hosung-cho/Bit_Up/C_SERV_ALU_FPGA/docs/260603_1455_백엔드.md

qflow synthesize -T etri050 serv_exec_unit
qflow place -T etri050 serv_exec_unit
qflow route -T etri050 serv_exec_unit
qflow migrate -T etri050 serv_exec_unit

cd layout
~/ETRI050_DesignKit/scripts/check_via_stack.py serv_exec_unit m2contact m3contact 6 | tee serv_exec_unit_Stacked.log

~/ETRI050_DesignKit/scripts/run_drc.sh serv_exec_unit | tee serv_exec_unit_DRC.log

~/ETRI050_DesignKit/scripts/run_lvs.sh serv_exec_unit | tee serv_exec_unit_LVS.log

[합성 후 시뮬레이션]
iverilog -g2005-sv -Tmin -gspecify \
  -o /tmp/serv_exec_unit_gate_tb \
  MPW_workspace/Bit_Up/C_SERV_ALU_FPGA/testbench/0_exec_unit_basic/tb_serv_exec_unit.v \
  ETRI-0.5um-CMOS-MPW-Std-Cell-DK/digital_ETRI/khu_etri05_stdcells.v \
  MPW_workspace/Bit_Up/C_SERV_ALU_FPGA/ETRI050_Ho/synthesis/serv_exec_unit_mapped.v

vvp /tmp/serv_exec_unit_gate_tb

make
make copy_pad_frame
make copy_core

[f-4. 코어와 입출력 패드 분리]
make extract_pad
make extract_pin_route
~/ETRI050_DesignKit/scripts/size_core.sh serv_exec_unit_Pin_Route

[배선 DRC]
magic -dnull -noconsole << EOF
drc off
box 0 0 0 0
load serv_exec_unit_Pin_Route.mag -force
select top cell
drc on
drc check
drc why
box
exit
EOF

[magic VLSI]
select cell instancename

make generate_gds

klayout -l ETRI050_CMOS.lyp serv_exec_unit_Top.gds
