hosung-cho/Bit_Up/A_MCU/docs/260520_0453_bridge_diet_area_recovery.md

# 260520_0453_bridge_diet_area_recovery

본 문서는 주변 시리얼 브리지 회로(`offchip_mem_bridge`, `serv_rf_ram_if`)의 제어 로직 및 FSM 다이어트를 수행한 1차 리팩토링 결과와 물리적 면적 재측정 보고서입니다.

---

## 1. 리팩토링 수행 내역

### A. `offchip_mem_bridge.v` 극단적 단순화
* **기존 방식**: `bit_count` 값에 따라 WE, IBUS, SEL 비트를 MUX하여 송신하느라 복잡한 비교기와 다단계 MUX 트리 조합 회로가 면적을 크게 소모함.
* **개선 방식**: `shift_reg` 크기를 32비트에서 **38비트**로 확장하여 헤더 데이터(active_we, active_ibus, active_sel)를 로드 시점에 사전 주입(Preload). `o_mem_mosi`는 오직 `shift_reg[37]` 최상위 비트 1개만을 바로 출력하도록 하여 **비교기 및 MUX 조합 회로를 완전히 제거**.

### B. `serv_rf_ram_if.v` 카운터 축소
* **기존 방식**: 시스템 클럭 기준으로 쓰기 대기 루프를 64사이클 대기하기 위해 `write_wait` 카운터를 6비트(`6'd63`)로 구현함.
* **개선 방식**: 시스템 클럭 1사이클이 패스트 클럭 32사이클에 해당하므로, 대기 카운터를 시스템 클럭 기준 **2사이클**(`2'd2`)로 대폭 축소. 카운터 크기를 **2비트**로 줄여 4개의 FF와 디코딩 로직을 제거함.

---

## 2. 시뮬레이션 및 백엔드 물리 결과

### A. 기능적 정합성 검증 (Vivado Simulation)
* 리팩토링 완료 후 `testbench/5_testbench_rv32i_directed/sim/run.sh` 를 통해 320개 RISC-V 32I Directed Testbench를 즉시 회귀 검증함.
* **검증 결과**: **100% PASS** (기능 및 오프칩 인터페이스 호환성 무결 입증)

### B. 백엔드 물리적 구현 및 면적 측정 결과
* Qflow 백엔드 합성, 배치 및 라우팅을 다시 수행하여 배치 밀도(`initial_density`)를 **`0.98`** 로 대폭 높여 설계를 조였습니다.

| 지표 | 리팩토링 전 (Density 0.90) | 리팩토링 + 고밀도 튜닝 (Density 0.98) | 개선율 |
| :--- | :---: | :---: | :---: |
| **Yosys Netlist Cells** | 2,291 개 | **2,260 개** | **31개 셀 제거** |
| **GrayWolf Placement Cells** | 2,483 개 | **2,451 개** | **32개 셀 제거** |
| **Routing Failure Nets** | 0 개 | **0 개 (100% Routing 완수)** | **정상 통과** |
| **최종 코어 가로 x 세로 크기** | 1350.6 um x 1341.75 um | **1305.9 um x 1269.75 um** | **가로 45um, 세로 72um 축소** |
| **최종 코어 면적 (Core Size)** | 1.81 mm² | **1.66 mm²** | **8.3% 추가 축소** |

---

## 3. 한계점 분석 및 최종 제언

브리지 로직 단순화와 `0.98` 극단적 배치 밀도 설정을 통해 **최종 면적을 `1.66 mm²` 까지 축소**하고 라우팅 에러 0개를 달성하는 훌륭한 성과를 거두었습니다. 

그러나 1mm x 1mm (1.00 mm²) 한계에 완전히 안착하기 위해서는 다음과 같은 본질적 구조 변경이 필요합니다:
* **포트/FSM 물리적 합병(Shared Serial Bus)**: 현재 메모리 액세스용 브리지와 RF RAM 액세스용 브리지가 각각 독립된 Shift Register와 카운터를 사용하여 약 850개 이상의 셀을 차지하고 있습니다. 이 두 채널을 단일 시리얼 버스 포트로 통합하고 시프트 버퍼를 공유하도록 아키텍처를 개조하면 추가로 약 300~400개 이상의 셀을 절감할 수 있으며, 이 경우에 한해 1mm x 1mm 이내 진입이 최종적으로 가능할 것으로 예상됩니다.
