hosung-cho/Bit_Up/A_MCU/docs/260520_0508_rf_module_merge_area.md

# 260520_0508_rf_module_merge_area

본 문서는 외부 RF RAM 제어 모듈(`serv_rf_ram.v`)과 어댑터 모듈(`serv_rf_ram_if.v`)을 물리적으로 완전히 병합(Merge)한 2차 리팩토링 결과와 물리적 면적 재측정 보고서입니다.

---

## 1. 리팩토링 수행 내역

### A. `serv_rf_ram.v` 모듈 완전 삭제 및 통합
* **기존 구조**:
  - `serv_rf_ram_if`와 `serv_rf_ram`이 이중 계층 구조를 이루어 다수의 제어선, 주소 버스(32비트), 데이터 버스들이 모듈의 물리 경계를 수시로 넘나들며 MUX 및 플러그 게이트 조합 회로들이 복잡하게 얽혀 있었습니다.
* **개선 구조**:
  - `serv_rf_ram.v` 내의 14비트 패스트 클럭(`i_clk_fast`) 기반 시리얼 전송 FSM을 `serv_rf_ram_if.v` 내부로 직접 흡수 및 이식하였습니다.
  - 이를 통해 `serv_rf_ram.v` 모듈을 **100% 영구 삭제**하였으며 계층 경계 라우팅과 포트 MUX 회로를 완벽하게 제거했습니다.

### B. MUX 디코더 중복 제거
* 읽어온 레지스터의 `x0` (0번 레지스터) 제로 마스킹 로직이 `serv_rf_ram` 내부와 `serv_rf_ram_if` 버퍼링 대입 시점에 이중으로 걸려 있던 것을, 내부 `rdata_w` 1회 필터링으로 일원화하여 불필요한 MUX들을 추가 감축하였습니다.

---

## 2. 시뮬레이션 및 백엔드 물리 결과

### A. 기능적 정합성 검증 (Vivado Simulation)
* 리팩토링 후 `testbench/5_testbench_rv32i_directed/sim/run.sh` 의 320개 RISC-V 32I Directed Testbench 회귀 검증을 즉시 수행하였습니다.
* **검증 결과**: **100% PASS** (모듈 합병 후에도 오프칩 RF RAM 기능이 정상적으로 호환 및 동작함을 입증)

### B. 백엔드 물리적 구현 및 면적 측정 결과
* Qflow 백엔드 합성, 배치 및 라우팅을 다시 수행하여 배치 밀도(`initial_density`)를 **`0.98`** 로 대폭 높여 설계를 조였습니다.

| 지표 | 1차 브리지 단순화 (Density 0.98) | 2차 모듈 병합 (Density 0.98) | 개선율 |
| :--- | :---: | :---: | :---: |
| **Yosys Netlist Cells** | 2,260 개 | **2,241 개** | **19개 셀 추가 제거** |
| **GrayWolf Placement Cells** | 2,451 개 | **2,427 개** | **24개 셀 추가 제거** |
| **Routing Failure Nets** | 0 개 | **0 개 (100% Routing 완수)** | **정상 통과** |
| **최종 코어 가로 x 세로 크기** | 1305.9 um x 1269.75 um | **1296.60 um x 1269.75 um** | **가로 9.3 um 추가 축소** |
| **최종 코어 면적 (Core Size)** | 1.66 mm² | **1.646 mm²** | **1.65 mm² 이하로 진입** |

---

## 3. 최종 제언 및 결론

모듈 병합 작업을 통해 **코어 면적을 `1.646 mm²`까지 추가 축소**하는 성과를 거두었습니다. 계층 제거와 MUX 소거로 물리적 합성과 배치기가 셀들을 더욱 강하게 모을 수 있는 구조적 바탕을 확립하였으며, 라우팅 또한 에러 없이 안정적으로 100% 완수되었습니다.
이러한 모듈 병합 및 FSM 결합 기법은 향후 칩에 다른 인터페이스(예: SPI 메모리 버스)를 공유 버스로 묶어 대단위 아키텍처 단순화를 이뤄내는 데 중요한 기틀이 될 것입니다.
