hosung-cho/Bit_Up/A_MCU/docs/260519_2040_MUX_최적화_후_물리_합성_면적_재검증.md

# 260519 20:40 MUX 최적화 후 물리 합성 면적 재검증

## 1. 목적
- GPR RAM 인터페이스 및 오프칩 메모리 브릿지의 Dynamic MUX 제거 최적화(Shift Register 구조 도입)가 실제 ETRI 0.5um 공정 QFlow 물리 합성 결과(DIE Area 및 Standard Cell Count)에 미친 영향을 정량적으로 비교 분석한다.

---

## 2. QFlow 물리 합성 결과 비교 분석 (USE_EXT_SYS_CLK = 1 기준)

MUX 최적화 이전(기존 외부 slow clock 모드)과 최적화 이후의 Yosys 합성 결과 및 DEF 배치 결과를 비교한 수치입니다.

| 항목 | 최적화 이전 (기존 외부 클록 모드) | 최적화 이후 (현재 결과) | 증감 수치 / 비율 |
| :--- | :---: | :---: | :---: |
| **전체 Logic Cells** | 2,660 개 | **2,894 개** | +234 개 (+8.8%) |
| **DFFPOSX1 (D Flip-Flop)** | 339 개 | **371 개** | +32 개 (+9.4%) |
| **OAI21X1 (Logic Gate)** | 563 개 | **701 개** | +138 개 (+24.5%) |
| **vlogFanout 추가 Buffers** | 241 개 | **296 개** | +55 개 (+22.8%) |
| **DEF Placement Components** | 4,822 개 | **5,273 개** | +451 개 (+9.4%) |
| **DEF DIE Area (폭 x 높이)** | 1449.0um x 1419.0um | **1491.0um x 1491.0um** | - |
| **DEF 최종 면적** | 2.056 mm² | **2.223 mm²** | **+0.167 mm² (+8.1%)** |

---

## 3. 면적 증가 원인 분석

### A. D Flip-Flop (DFFPOSX1)의 물리적 면적 부하
- `offchip_mem_bridge.v`에서 기존에 MUX 트리(70비트 wire)로 직접 나가던 구조를 32비트 송신용 쉬프트 레지스터(`shift_tx`)로 구조화하면서 **32비트의 DFF가 설계에 추가**되었습니다.
- ETRI 0.5um 공정에서 `DFFPOSX1`은 1개당 `36um x 36um`로, 일반 게이트(예: `INVX1` `6um x 36um`, `NAND2X1` `12um x 36um`) 대비 물리적 폭이 3배에서 6배에 달할 정도로 면적 소모가 매우 큽니다. 따라서 32개의 DFF가 추가된 것만으로도 막대한 물리 면적 부하를 유발했습니다.

### B. Shift & Hold 멀티플렉싱에 따른 추가 로직 게이트 발생
- MUX 구조는 Yosys 합성기에서 조합 회로(combinational cell)로 공유 및 간소화되기 쉬운 형태입니다.
- 반면, 쉬프트 레지스터는 각 플롭의 입력(D)단에 **[1] 기존 데이터 홀드**, **[2] 1비트 우측 쉬프트**, **[3] 2비트 우측 쉬프트**, 또는 **데이터 로드**의 다중 조건 분기를 처리하기 위한 개별 멀티플렉서 기능(MUX2X1 및 OAI21X1/AOI21X1 복합 게이트)이 모든 비트마다 독립적으로 부착되어야 합니다.
- 이로 인해 `OAI21X1`이 **563개에서 701개**로 138개나 폭증하였으며, 이것이 전체 로직 셀 증가의 주요 원인이 되었습니다.

### C. Fanout 버퍼 추가 증가
- 레지스터(DFF)의 개수 증가 및 쉬프트 레지스터의 인에이블/제어 신호 로드가 분산되면서 `vlogFanout` 단계에서 추가적으로 삽입된 버퍼의 개수가 241개에서 **296개**로 늘어났습니다.

---

## 4. 결론 및 향후 개선 방향
- **분석 결론**: Dynamic MUX 트리를 Shift Register 구조로 변경하면 논리 레벨(Logical Area Metric) 상의 대형 MUX는 제거되어 정돈되는 효과가 있으나, 실제 ETRI 0.5um 공정의 물리적 Standard Cell 배치 레벨에서는 **추가된 32비트 DFF의 면적 부하** 및 **비트별 쉬프트 선택 로직 오버헤드**가 더 지배적이어서 **실제 DIE Area는 8.1% 증가**하는 결과를 낳았습니다.
- **향후 방향**:
  1. GPR RAM 인터페이스 및 브릿지 구조에서 Shift Register를 사용한 완전 순차 직렬화 대신, **합성 단계에서 논리 연산 공유가 가능한 최소 단위의 MUX 분할 구조**를 재설계하는 것이 실질적인 셀 폭 감소에 유리할 수 있습니다.
  2. 목표 면적인 `1.0 mm²` 진입을 위해서는 단순한 MUX 구조 수정뿐만 아니라, **UART/GPIO 등 부가 IO 모듈의 제거**, **프레임 비트 폭 자체의 대폭 축소(예: 32비트에서 16/8비트 직렬화)** 등 구조적 크기를 과감히 도려내는 탑 레벨 분리 시도가 필수적입니다.
