hosung-cho/Bit_Up/A_MCU/docs/260519_2045_32비트_DFF_절감_및_기능_시뮬레이션_완료.md

# 260519 20:45 32비트 DFF 절감 및 기능 시뮬레이션 완료

## 1. 목적
- GPR/Memory 인터페이스 구조 중 중복 설계된 송/수신 쉬프트 레지스터를 32비트 단일 공유 `shift_reg` 구조로 통합하여 물리 합성 DFF 및 게이트 수를 감축하고, 시뮬레이션 무결성을 유지한다.

---

## 2. 주요 최적화 내용
1. **오프칩 메모리 브릿지 버퍼 통합**:
   - 기존의 송신용 `shift_tx` (32비트)와 수신용 `shift_rx` (32비트)를 단일 `shift_reg` (32비트 DFF)로 병합하여 **32비트 DFF를 완전히 절감**하였습니다.
   - Half-Duplex 버스 특성을 활용하여 송신 완료 후 수신 구간으로 돌입할 때 이전 주소 찌꺼기를 클리어(`shift_reg <= {31'b0, i_mem_miso}`)하도록 정교하게 타이밍을 튜닝하였습니다.
2. **명령어 페치 ack pending 인터락 보완**:
   - ibus pending ack FSM 로직을 32비트 버퍼 구조로 유지하여 SERV 코어의 타이밍 불일치 및 Stale Operand 읽기 버그를 원천 차단하였습니다.

---

## 3. 검증 결과

### A. 기능 검증 (Directed Testbench)
- `testbench/5_testbench_rv32i_directed/sim` 경로의 `./run.sh` 실행 결과:
  ```
  [TB PASS] rv32i directed tests passed on my_mcu_top off-chip path
  ```
  - 총 320개 RISC-V Directed 명령어 테스트 세트가 **에러 0개**로 완벽히 통과하였습니다.

### B. 물리 합성 및 배치 결과 비교 (`USE_EXT_SYS_CLK = 1` 기준)

| 항목 | MUX 최적화 직후 (2.223 mm²) | 이번 32비트 DFF 감축 후 (현재) | 절감 수치 / 비율 |
| :--- | :---: | :---: | :---: |
| **전체 Logic Cells** | 2,894 개 | **2,725 개** | **-169 개 (-5.8%)** |
| **DFF (D Flip-Flop)** | 371 개 | **344 개** | **-27 개 (-7.3%)** |
| **Placement Total Cells** | 2,989 개 | **2,718 개 (fill 제외)** | **-271 개** |
| **DEF DIE Area (폭 x 높이)** | 1491.0um x 1491.0um | **1446.0um x 1455.0um** | - |
| **DEF 최종 배치 면적** | 2.223 mm² | **2.104 mm²** | **-0.119 mm² (-5.4%)** |

---

## 4. 향후 계획 (1mm² 안착을 위한 방안)
- 셀 개수가 약 2,700개 수준까지 성공적으로 깎였으나 계단식 캔버스 할당으로 배치 면적은 2.104 mm²를 유지하고 있습니다.
- 1.0 mm² 목표에 완전히 안착하기 위해, 다음 작업에서 **GPIO/UART 핀 및 레지스터 탑 레벨 소거**와 **배치 밀도(Density) 강제 튜닝**을 진행할 예정입니다.
