hosung-cho/Bit_Up/A_MCU/docs/260519_1945_물리구현_결과_기반_면적_최적화_방안.md

# 260519 19:45 물리 구현 결과 기반 면적 최적화 방안

## 1. 물리 배치 및 레이아웃 로그 분석 (ETRI 0.5um 공정 타겟)

물리 배치 툴(GrayWolf) 및 라우팅 툴(qrouter)의 로그(`place.log`)와 설정 파일(`project_vars.sh`)을 정밀 분석한 결과는 다음과 같습니다.

### ① 배치 밀도 (Standard Cell Density / Utilization)
* **설정값**: `initial_density = 0.90` (90%)
* **실제 매핑 결과**:
  * 스탠다드 셀(Other cells): 2,894개
  * 채움 셀(Fill cells): 1,855개
  * 실 스탠다드 셀 점유 폭 비율: **88.89%** (약 89% 수준의 극도로 높은 집적도 유지)
* **해석**: 3층 금속 배선 레이어(M1, M2, M3)만 사용하는 구형 ETRI 0.5um 공정에서 89%의 배치 밀도는 물리적으로 **거의 한계치**에 다다른 수준입니다. 90% 이상으로 밀도를 강제 조절할 경우 배치 툴의 겹침 현상(overlap)이나 라우팅 채널 부족으로 인해 최종 라우팅 실패(Congestion)가 발생할 확률이 매우 높습니다. 
* **결론**: 물리적인 배치 밀도 파라미터 튜닝만으로는 추가적인 면적 감소가 불가능하며, **스탠다드 셀(특히 플립플롭)의 물리적 크기와 개수 자체를 줄여야 합니다.**

### ② 배선 레이어 제한에 따른 전력 구조(Power Strip) 손실
* **배선 레이어 수**: 3 Layers (M1, M2, M3)
* **로그 내용**: `Will not generate over-cell power stripes due to lack of route layers. Generating comb structures instead.`
* **해석**: 라우팅용 금속판이 3개층뿐이라 셀 위를 교차하는 통상적인 메쉬(Mesh)형 전력 배선(Power Stripe)을 생성하지 못하고, 칩 외곽을 둘러싸는 빗 모양(Comb) 전력 배선 구조를 사용하고 있습니다. 
* **결론**: Comb 구조는 외곽 전력 라인의 두께와 가드로 인해 Die Area 마진을 더 많이 요구하게 됩니다. 라우팅을 방해하지 않는 선에서 Comb 전력 라인의 폭을 최적화할 필요가 있습니다.

---

## 2. ETRI 0.5um 공정 라이브러리 특성 분석

물리 합성(`synth.log`)에 정의된 ETRI 0.5um CMOS 표준 셀 라이브러리(`khu_etri05_stdcells.lib`)의 셀별 물리 면적(Chip Area) 값은 다음과 같습니다.

| 표준 셀 이름 | 기능 및 특징 | 물리 면적 (Area 수치) | 인버터(`INVX1`) 대비 크기 비율 |
| :--- | :--- | :---: | :---: |
| **`INVX1`** | 기본 인버터 | 144 | 1.0배 |
| **`NAND2X1`** | 2입력 NAND 게이트 | 216 | 1.5배 |
| **`AND2X1`** | 2입력 AND 게이트 | 288 | 2.0배 |
| **`DFFPOSX1`** | 일반 D-플립플롭 | **864** | **6.0배** |
| **`DFFSR`** | **비동기 Reset/Set 지원 D-플립플롭** | **1,584** | **11.0배** |

### ⚠️ 핵심 발견: DFFSR 셀의 비정상적으로 큰 물리 면적
* 비동기 리셋 및 셋 단자를 모두 지원하는 `DFFSR` 플롭은 단일 셀 면적이 **1,584**로, 일반 플립플롭(`DFFPOSX1`)의 **1.8배**, 기본 NAND 게이트의 **7.3배**, 인버터의 **11배**에 달하는 초대형 셀입니다.
* 현재 `my_mcu_top.v`에는 인터록 명령어 대기 버퍼(`ibus_pending_rdt[31:0]`)를 포함하여 총 46개의 비동기 리셋 레지스터가 존재하며, 이들은 전부 이 거대한 `DFFSR` 셀로 합성되었습니다.
* 이 46개의 `DFFSR`이 차지하는 물리 면적 합계만 **72,864**에 달해 `my_mcu_top` 로컬 면적의 절반 이상을 차지합니다.

---

## 3. 물리 구현 관점에서의 면적 최소화 방안

공정 라이브러리의 물리적 특성과 레이아웃 제약을 극복하기 위해 제안하는 구체적인 물리적 면적 최적화 기법입니다.

### 💡 제안 1: 비동기 리셋(`DFFSR`)을 동기 리셋(`DFFPOSX1`+조합회로)으로 전환
* **원리**: 
  * 현재의 `always @(posedge clk_sys or posedge rst)` 구조의 비동기 리셋을 `always @(posedge clk_sys)` 기반의 **동기 리셋(Synchronous Reset)** 구조로 모두 전환합니다.
  * 동기 리셋으로 설계할 경우 Yosys는 비동기식 대형 `DFFSR` 셀 대신, 훨씬 크기가 작은 일반 `DFFPOSX1` (864) 셀의 데이터 입력 D단 앞에 리셋 조합 회로(AND 등)를 결합하여 합성하게 됩니다.
* **물리 면적 절감 효과**:
  * 비동기 `DFFSR` 1개 면적: **1,584**
  * 동기식 구현 면적: `DFFPOSX1` (864) + `AND2X1` (288) = **1,152** (셀 1개당 무조건 432의 면적이 즉시 절감됨)
  * 또한, 리셋이 0으로 풀리는 단순 레지스터의 경우 Yosys가 전단 조합 논리와 리셋 AND 회로를 병합(Logic Optimization)해 주므로, 실제 288 면적의 AND 게이트조차 상당 부분 축소되거나 완전히 병합되어 면적이 1,152 이하로 내려갑니다.
  * MCU 전체의 비동기 리셋 플롭을 동기 리셋으로 전환 시, **수 만 단위의 물리 면적이 소스 코드 수정 없이 합성기 최적화만으로도 절감**됩니다.

### 💡 제안 2: Wishbone 버스 게이팅을 활용한 플립플롭 원천 제거 (DFF 카운트 최소화)
* **원리**: 앞선 논리 분석에서 도출된 Wishbone `cyc` 게이팅 기반 인터록 지연 방식을 적용하면 32비트 명령어 대기 버퍼 자체를 아예 지울 수 있습니다.
* **물리 면적 절감 효과**:
  * 이 변경은 단순히 게이트 수를 줄이는 것을 넘어, ETRI 0.5um 공정에서 가장 비싼 `DFFSR` 셀을 32개 이상 통째로 들어내는 효과를 갖습니다.
  * `32개 * 1,584 (DFFSR 면적) = 50,688` 면적이 물리 레이아웃에서 즉각 삭제됩니다.

### 💡 제안 3: Comb 전력 스트라이프 폭 마진 조정
* **원리**: Qflow 배치 스크립트(`addspacers`)의 전력선 폭 제약 파라미터를 조정하여 외곽 Comb 구조의 Guard Ring 폭 및 내부 전력 밀도를 다듬습니다.
* **물리 면적 절감 효과**:
  * 3 Layer 메탈 한계상 외곽 Comb 라인이 강제되므로, 이 외곽 전력 라인의 폭을 수 마이크론 단이로 최적화해 주는 것만으로도 칩의 전체 테두리(Die Area)를 크게 줄일 수 있는 물리적 여유가 생깁니다.

---

## 4. 요약 및 권고사항

ETRI 0.5um 구형 공정에서는 **플립플롭(특히 비동기 리셋 플롭)이 면적 낭비의 근본 원인**으로 확인되었습니다. 물리 구현의 한계를 극복하고 1mm² 영역에 근접하기 위한 권고사항은 다음과 같습니다.

1. **동기 리셋 적극 도입**: `my_mcu_top` 및 우리가 수정한 시리얼 브릿지 내의 모든 `always @(posedge clk or posedge rst)` 구문을 `always @(posedge clk)` 형태의 동기식 리셋으로 통일해 초대형 `DFFSR` 셀 유입을 차단합니다.
2. **Shift Register 구조 도입을 통한 MUX 축소**: 물리 레이아웃 배선층이 3개뿐이므로, 70:1 MUX나 32:1 MUX는 수많은 배선 혼잡도를 유발하고 필 셀(Fill cell)을 강제 배치하게 만듭니다. MUX를 Shift Register로 분해하면 배선 레이아웃 복잡도도 함께 줄어들게 됩니다.
3. **인터록 단순화**: `DFFSR` 개수를 절대적으로 줄이기 위해 32비트 명령어 지연 버퍼를 Wishbone 게이팅 방식으로 리팩토링합니다.
