hosung-cho/Bit_Up/A_MCU/backend_physical_qflow/synthesis/my_mcu_top_synth.rtl.v

/* Verilog module written by vlog2Verilog (qflow) */
/* With explicit power connections */

module my_mcu_top(
    inout vdd,
    inout gnd,
    input i_clk_fast,
    input i_clk_sys_ext,
    input i_rst_n,
    output o_mem_sync,
    output o_mem_sck,
    output o_mem_mosi,
    input i_mem_miso
);

wire o_mem_sck ;
wire current_stream_rs2_hint ;
wire _588_ ;
wire _168_ ;
wire _800_ ;
wire _60_ ;
wire _1066_ ;
wire _397_ ;
wire [0:0] \u_cpu.ctrl.pc_plus_4_cy_r_w  ;
wire _703_ ;
wire [4:0] \u_cpu.decode.opcode  ;
wire _19_ ;
wire _932_ ;
wire _512_ ;
wire _1198_ ;
wire _741_ ;
wire _321_ ;
wire _57_ ;
wire _970_ ;
wire _550_ ;
wire _130_ ;
wire [4:2] \u_cpu.state.o_cnt  ;
wire _606_ ;
wire _835_ ;
wire _415_ ;
wire _95_ ;
wire _644_ ;
wire _224_ ;
wire _1122_ ;
wire _873_ ;
wire _453_ ;
wire _929_ ;
wire _509_ ;
wire _682_ ;
wire _262_ ;
wire _738_ ;
wire _318_ ;
wire _1160_ ;
wire _491_ ;
wire _1216_ ;
wire _967_ ;
wire _547_ ;
wire _127_ ;
wire _1025_ ;
wire _776_ ;
wire _356_ ;
wire _585_ ;
wire _165_ ;
wire _1063_ ;
wire _394_ ;
wire _1119_ ;
wire _679_ ;
wire _259_ ;
wire _1157_ ;
wire _488_ ;
wire _700_ ;
wire _297_ ;
wire _16_ ;
wire _1195_ ;
wire _54_ ;
wire _603_ ;
wire _832_ ;
wire _412_ ;
wire _92_ ;
wire _1098_ ;
wire _641_ ;
wire _221_ ;
wire _870_ ;
wire _450_ ;
wire _926_ ;
wire _506_ ;
wire _735_ ;
wire _315_ ;
wire [3:0] rf_wreg0_to_if ;
wire _1213_ ;
wire _964_ ;
wire _544_ ;
wire _124_ ;
wire _1022_ ;
wire _773_ ;
wire _353_ ;
wire _829_ ;
wire _409_ ;
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
    .B(_102_),
    .Y(_742_)
);

NAND3X1 _2168_ (
    .vdd(vdd),
    .gnd(gnd),
    .A(\u_rf_if.rcnt [0]),
    .B(\u_rf_if.rcnt [2]),
    .C(\u_rf_if.rcnt [1]),
    .Y(_103_)
);

OAI21X1 _2169_ (
    .vdd(vdd),
    .gnd(gnd),
    .A(_1145_),
    .B(_21_),
    .C(_1225_),
    .Y(_104_)
);
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
