hosung-cho/Bit_Up/A_MCU/testbench/4_2_testbench_my_mcu_top_no_csr/tb_my_mcu_top_no_csr.v

`timescale 1ns/1ps

module tb_my_mcu_top_no_csr;
   localparam RF_RAW = 5;
   localparam RF_REGS = 32;
   localparam RF_FRAME_BITS = RF_RAW + 8;
   localparam RESULT_BASE = 32'h0000_0700;

   localparam OPC_LUI       = 7'b0110111;
   localparam OPC_JAL       = 7'b1101111;
   localparam OPC_JALR      = 7'b1100111;
   localparam OPC_BRANCH    = 7'b1100011;
   localparam OPC_LOAD      = 7'b0000011;
   localparam OPC_STORE     = 7'b0100011;
   localparam OPC_ARI_RTYPE = 7'b0110011;
   localparam OPC_ARI_ITYPE = 7'b0010011;

   localparam FNC_BEQ     = 3'b000;
   localparam FNC_BNE     = 3'b001;
   localparam FNC_LW      = 3'b010;
   localparam FNC_SB      = 3'b000;
   localparam FNC_SH      = 3'b001;
   localparam FNC_SW      = 3'b010;
   localparam FNC_ADD_SUB = 3'b000;
   localparam FNC_SLL     = 3'b001;
   localparam FNC_XOR     = 3'b100;
   localparam FNC7_0      = 7'b0000000;

   reg clk_fast = 1'b0;
   reg rst_n = 1'b0;
   always #31.25 clk_fast = ~clk_fast;

   wire rf_sync;
   wire rf_sck;
   wire rf_mosi;
   wire rf_miso;
   wire mem_sync;
   wire mem_sck;
   wire mem_mosi;
   wire mem_miso;
   wire [7:0] gpio_out;
   wire [7:0] gpio_oe;

   my_mcu_top dut (
      .i_clk_fast(clk_fast),
      .i_rst_n(rst_n),
      .o_rf_sync(rf_sync),
      .o_rf_sck(rf_sck),
      .o_rf_mosi(rf_mosi),
      .i_rf_miso(rf_miso),
      .o_mem_sync(mem_sync),
      .o_mem_sck(mem_sck),
      .o_mem_mosi(mem_mosi),
      .i_mem_miso(mem_miso),
      .o_uart_tx(),
      .i_uart_rx(1'b1),
      .i_gpio(8'ha5),
      .o_gpio(gpio_out),
      .o_gpio_oe(gpio_oe)
   );

   reg [31:0] pico_ram [0:RF_REGS-1];
   reg [RF_FRAME_BITS-1:0] rx_buffer = 0;
   integer bit_cnt = 0;
   reg [1:0] pico_tx_data = 0;
   integer frame_cnt = 0;
   integer write_frame_cnt = 0;
   integer read_frame_cnt = 0;
   integer invalid_rf_frame_cnt = 0;

   reg [31:0] ext_mem [0:511];
   reg [69:0] mem_rx_buffer = 0;
   integer mem_bit_cnt = 0;
   reg [31:0] mem_read_shift = 0;
   reg [31:0] mem_addr = 0;
   reg [31:0] mem_wdata = 0;
   reg [3:0] mem_sel = 0;
   integer mem_word_index = 0;
   integer mem_frame_cnt = 0;
   integer mem_write_cnt = 0;
   integer mem_read_cnt = 0;
   integer fetch_cnt = 0;
   reg [31:0] last_ibus_adr = 0;
   reg [31:0] last_ibus_insn = 0;

   reg expected_valid [0:511];
   reg [31:0] expected_mem [0:511];
   reg [5:0] expected_case_id [0:511];
   reg [8*64-1:0] case_name [0:63];

   integer i;
   integer pc_word;
   integer result_addr;
   integer error_cnt = 0;
   integer case_count = 0;

   function [31:0] enc_r;
      input [6:0] funct7;
      input [4:0] rs2;
      input [4:0] rs1;
      input [2:0] funct3;
      input [4:0] rd;
      begin
         enc_r = {funct7, rs2, rs1, funct3, rd, OPC_ARI_RTYPE};
      end
   endfunction

   function [31:0] enc_i;
      input [31:0] imm;
      input [4:0] rs1;
      input [2:0] funct3;
      input [4:0] rd;
      input [6:0] opcode;
      begin
         enc_i = {imm[11:0], rs1, funct3, rd, opcode};
      end
   endfunction
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
