hosung-cho/Bit_Up/(commit log)

2026-05-15 docs 파일 추가
2026-05-15 serv 원본 코드 추가
2026-05-15 External RF(Off-chip Register File)를 위한, serv_rf_ram.v 수정, tb_external_rf 추가
    [tb_external_rf.v]
2026-05-15 시뮬레이션 관련 파일 추가 및 .gitignore 업데이트
2026-05-15 serv 폴더 이동
2026-05-16 테스트벤치 폴더 정리
2026-05-16 SoC 최상위 모듈(my_mcu_top.v) 추가, 오프칩 RF 통합
2026-05-16 my_mcu_top 클럭 수정 - my_mcu_top 모듈의 클럭 입력을 i_clk_fast로 변경하고, 클럭 분주 로직을 수정하여 시스템 클럭을 개선함. 테스트벤치에서 클럭 입력을 업데이트하고, 시뮬레이션 대기 시간을 조정함.
    [my_mcu_top.v, tb_my_mcu_top.v]
2026-05-16 Wishbone 버스와 주변장치 연계 구조 문서 추가
2026-05-16 test 삭제
2026-05-16 my_mcu_top 모듈에 오프칩 메모리 브리지 추가 및 RF 인터페이스 개선 - my_mcu_top.v: 오프칩 메모리 브리지와 관련된 신호 추가 및 RF 레지스터 읽기 로직 수정 - serv_rf_ram_if.v: 쓰기 대기 카운터 비트 수 증가 및 관련 로직 수정 - serv_top.v: immdec 모듈에 SHARED_RFADDR_IMM_REGS 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
    [my_mcu_top.v, offchip_mem_bridge.v, tb_my_mcu_top.v]
2026-05-16 오프칩 메모리 통합 및 RF writeback ordering 수정
    - testbench에서 GPIO 핀을 추가하고, GPIO 관련 신호를 DUT에 연결함.
    - 메모리 맵을 확장하여 pico_ram의 크기를 16에서 32로 증가시킴.
    - off-chip 메모리 브리지와 RF 어댑터의 통합 테스트를 위한 새로운 테스트 프로그램 추가.
    - RF writeback ordering 문제를 해결하기 위해 serv_rf_ram_if 모듈에 forwarding table 추가.
    - simple_gpio 모듈을 추가하여 메모리 맵 GPIO 슬레이브 구현.
    - 기존 임시 보정 로직을 제거하고, RF 어댑터 내부에서 write-after-read ordering을 보장하도록 수정.
    - 통합 테스트에서 ALU writeback 결과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
    [my_mcu_top.v, simple_gpio.v, tb_my_mcu_top.v]
2026-05-16 폴더 구조 변경 - A_MCU, B_8bit 폴더 추가
2026-05-16 B_8bit 추가
2026-05-16 ALU writeback 오염 문제 해결을 위한 RF writeback ordering 수정
    [my_mcu_top.v, tb_rf_if_serial.v]
2026-05-16 브랜치 점프 및 CSR Smoke 테스트와 Off-chip/Pico Parser 동기화 작업 추가 - RF serial frame width를 14-bit로 확장하고, CSR shadow register를 포함하여 기존 13-bit에서 변경하였습니다. - CSR write/readback 경로를 수정하여 `mscratch`, `mtvec`, `mepc`,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
    [my_mcu_top.v, tb_my_mcu_top.v, tb_rf_if_serial.v, tb_serial_external_rf.v]
2026-05-16 RV32I ISA smoke 테스트 추가 및 RF writeback 문제 수정
    [my_mcu_top.v, tb_my_mcu_top.v]
2026-05-17 mepc RAW hazard 해결 및 RF read 주소 디코딩 기능 추가
2026-05-17 RV32I Off-chip MCU 진행상태 및 테스트 확장 계획 문서 추가
2026-05-17 테스트벤치 및 시뮬레이션 스크립트 추가
    - 메모리 및 레지스터 파일 경로를 정의하는 mem_path.vh 파일 추가
    - RISC-V 명령어와 기능 코드를 정의하는 opcode.vh 파일 추가
    - Vivado 시뮬레이션을 위한 run.bat 및 run_sim.tcl 파일 추가
    - 외부 프로그램을 위한 smoke 테스트를 포함하는 external_smoke.S 및 링크 스크립트 link.ld 추가
    - 테스트벤치에서 사용할 .gitignore 파일 추가
    - 외부 smoke 테스트를 빌드하는 build_external_smoke.sh 스크립트 추가
    - rv32i_directed 테스트벤치 tb_rv32i_directed.v 파일 추가
2026-05-17 테스트벤치에 외부 스모크 테스트 추가
    - 새로운 어셈블리 파일 `external_smoke.S` 추가: 기본적인 레지스터 쓰기 및 무한 루프 구현.
    - 링커 스크립트 `link.ld` 추가: 텍스트 섹션 정의.
    - `.gitignore` 파일 추가: 생성된 파일 및 작업 공간 디렉토리 무시.
    - 외부 스모크 테스트 빌드 스크립트 `build_external_smoke.sh` 추가: ELF 및 바이너리 파일 생성, 메모리 초기화 파일 생성.
    - 시뮬레이션 실행 스크립트 `run.sh` 추가: Vivado 배치 모드에서 시뮬레이션 실행.
    - 직접 시뮬레이션 실행 스크립트 `run_direct.sh` 추가: Verilog 소스 파일 컴파일 및 시뮬레이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
2026-05-17 외부 Hex 시뮬레이션 정상화 및 기본값 설정을 위한 환경 변수 추가
2026-05-17 외부 Hex 기반 RV32I Directed Regression 완전 구축 및 PASS 검증 문서 추가
2026-05-17 테스트벤치 rv32i 컴플라이언스 추가(RISC-V 공식 테스트): Vivado Tcl 스크립트 및 Verilog 테스트벤치 파일 생성
2026-05-17 Dhrystone 2.1 벤치마크를 위한 RISC-V 테스트벤치 추가
    - 링크 스크립트(link.ld) 추가
    - Dhrystone 실행 파일(dhrystone.bin) 및 ELF 파일(dhrystone.elf) 생성
    - 외부 헥스 파일 설정을 위한 Verilog 파일(external_hex_config.vh, external_hex_init.vh) 추가
    - 프로그램 헥스 파일(program.hex) 및 원시 헥스 파일(program.hex.raw) 생성
    - 외부 사용 플래그(use_external.flag) 추가
    - 시뮬레이션 실행 스크립트(run.sh) 추가
    - Vivado Tcl 시뮬레이션 스크립트(run_sim.tcl) 추가
    - Dhrystone 테스트벤치(tb_rv32i_dhrystone.v) 추가
2026-05-17 ETRI 0.5um 공정에 대한 Yosys 합성 스크립트 및 보고서 추가
2026-05-17 serv_rf_ram_if 모듈의 레지스터 구조 최적화 및 Dhrystone 벤치마크 관련 파일 업데이트
2026-05-17 serv_rf_ram_if 모듈의 레지스터 구조 최적화: bypass_ram 및 bypass_valid 크기 조정
2026-05-17 my_mcu_top 모듈의 클럭 및 리셋 구조 단순화, offchip_mem_bridge 모듈의 불필요한 레지스터 제거, serv_rf_ram_if 모듈의 데이터 처리 방식 개선
2026-05-17 my_mcu_top 모듈의 클럭 및 리셋 구조 개선, offchip_mem_bridge 모듈의 레지스터 출력 타입 변경, serv_rf_ram_if 모듈의 레지스터 구조 최적화, tb_rv32i_directed 테스트벤치의 파라미터 조정
2026-05-17 my_mcu_top 모듈의 CSR 처리 조건 수정, serv_rf_ram 모듈의 레지스터 크기 최적화 및 데이터 처리 방식 개선
    [my_mcu_top.v]
2026-05-17 serv_rf_ram_if 모듈의 write_wait 크기 조정 및 불필요한 레지스터 제거, 데이터 처리 방식 개선
2026-05-17 백엔드 논리 합성 성공 보고서 및 오프칩 RF 최적화 마일스톤 문서 추가, 주요 코드 수정 및 시뮬레이션 검증 완료. - 기존 문서 삭제 및 새로운 문서 생성 - my_mcu_top 모듈의 첫 명령어 패치 로직 개선 - offchip_mem_bridge 모듈의 비동기 리셋 및 ACK 신호 개선 - serv_rf_ram 모듈의 TX 상태 로직 수정 - se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
    [my_mcu_top.v, offchip_mem_bridge.v, tb_rv32i_hex.v]
2026-05-18 my_mcu_top 모듈의 레지스터 및 데이터 처리 방식 개선, serv_decode 모듈에 rf_wdata0_next 출력 추가, serv_rf_ram_if 모듈의 데이터 처리 방식 수정, 테스트벤치에서 RF_FRAME_BITS 관련 수정
    [my_mcu_top.v, tb_my_mcu_top.v, tb_rf_if_serial.v]
2026-05-18 serv_rf_ram 및 serv_rf_ram_if 모듈의 레지스터 접근 조건 수정, tb_rv32i_directed 테스트벤치에서 메모리 쓰기 및 PC 출력 관련 디스플레이 추가, 여러 테스트 케이스의 기대값 조정, 새로운 로그 파일 처리 스크립트 추가
2026-05-18 docs 수정
2026-05-18 RV32I Directed 테스트벤치의 가짜 PASS 문제 수정 및 RF Writeback Phase 해결 - serv_rf_ram_if.v에서 wdata0_next_phase 추가하여 write burst 기준으로 데이터 선택 - serv_decode.v, serv_top.v에서 관련 신호 수정 - tb_rv32i_directed.v의 기대값을 RV32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
    [tb_rv32i_directed.v]
2026-05-18 테스트벤치 관련 스크립트 추가 및 수정: dump_code.py, dump_mem.py, parse_tb.py, patch_serv_top_pc.py, patch_tb_dbus_we.py, patch_tb_time.py 파일 생성
2026-05-18 TB4-2, CSR 없는 my_mcu_top을 위한 테스트벤치 추가 및 관련 스크립트 생성
2026-05-18 external_smoke.S 및 build_external_smoke.sh 수정
    - external_smoke.S에서 sw 명령어를 CHECK_SW 매크로로 교체하여 결과 검증 시 4개의 NOP을 추가하여 안정성을 높임.
    - build_external_smoke.sh에서 0xdeadbeef 데이터를 program.hex의 비실행 데이터 영역에 주입하도록 수정.
    - 6번 테스트가 5번 테스트와 동일한 RV32I smoke 범위를 검증하도록 개선.
2026-05-18 테스트벤치의 프로그램 및 예상 메모리 파일을 업데이트하고, XSim 실행 스크립트를 수정하여 hex 파일을 canonical 위치에 덮어쓰도록 변경함. 또한, 리셋 신호의 지연 시간을 200ns에서 20000ns로 증가시켜 초기화 시간을 연장함. 여러 바이너리 및 ELF 파일이 변경됨.
    [tb_rv32i_compliance.v]
2026-05-19 my_mcu_top 모듈에 RF 인터록 및 메모리 인터페이스 신호 추가, 프로그램 헥스 파일 수정, 시뮬레이션 스크립트에 RF 트레이스 정의 추가, 테스트벤치에서 RF 읽기/쓰기 시그널 로깅 기능 개선
    [my_mcu_top.v, tb_rv32i_compliance.v]
2026-05-19 my_mcu_top 모듈에 RF 인터록 및 메모리 인터페이스 신호 추가, RF 읽기/쓰기 시그널 로깅 기능 개선. 테스트벤치의 프로그램 및 예상 메모리 파일 업데이트, XSim 실행 스크립트 수정, 리셋 신호 지연 시간 증가. external_smoke.S 및 build_external_smoke.sh 수정, TB4-2 테스트벤치 추가. 테스트벤치 관련 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
    [my_mcu_top.v, tb_rv32i_compliance.v, tb_rv32i_dhrystone.v]
2026-05-19 ETRI 0.5um QFlow Physical Implementation 초기 결과 문서 추가
    [my_mcu_top.cfg]
2026-05-19 my_mcu_top 모듈에 외부 느린 클럭 입력 옵션 추가 및 내부 분주기 제거 - CLK_SYS_DIV 및 USE_EXT_SYS_CLK 파라미터 추가 - i_clk_sys_ext 입력 포트 추가 - 내부 클럭 생성 로직을 generate 블록으로 변경하여 외부 클럭 사용 시 내부 분주기 제거
    offchip_mem_bridge 모듈에서 상태 축소 및 클럭 동기화 개선
    - SYS_CLK_EQUALS_FAST 파라미터 추가
    - 클럭 상승 엣지 감지를 sys_tick으로 통합하여 상태 관리 최적화
    serv_rf_ram 모듈에서 요청 지연 처리 개선
    - LAUNCH_DELAY 파라미터 추가하여 요청 처리 지연 조정 가능
    외부 느린 클럭 및 직렬 브리지 면적 검토 문서 추가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
    [my_mcu_top.cfg]
2026-05-19 MCU 면적 분석 및 최적화 방안 문서 추가
2026-05-19 면적 최적화를 위한 커스텀 합성 스크립트 추가 및 관련 문서 작성
    - A_MCU/backend_physical_qflow/source/my_mcu_top_custom.ys: 면적 최적화를 위한 커스텀 합성 스크립트 추가
    - A_MCU/docs/260519_2030_면적_최적화_구현_완료_및_기능_검증.md: 외부 Slow Clock 및 Serial Bridge 면적 최적화 완료 및 기능 검증 문서 작성
    - A_MCU/docs/260519_2040_MUX_최적화_후_물리_합성_면적_재검증.md: MUX 최적화 후 물리 합성 면적 재검증 문서 작성
    - A_MCU/docs/260519_2045_32비트_DFF_절감_및_기능_시뮬레이션_완료.md: 32비트 DFF 절감 및 기능 시뮬레이션 완료 문서 작성
    - A_MCU/docs/260519_2357_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
    [my_mcu_top.cfg]
2026-05-20 리팩토링: offchip_mem_bridge 및 serv_rf_ram_if 모듈 개선
    - offchip_mem_bridge.v에서 shift_reg 크기를 32비트에서 38비트로 확장하여 복잡한 MUX 및 비교기 제거
    - serv_rf_ram_if.v에서 write_wait 카운터를 6비트에서 2비트로 축소하여 면적 절감
    - serv_rf_ram.v 모듈 삭제 및 serv_rf_ram_if.v에 통합하여 계층 경계 제거
    - 불필요한 MUX 디코더 중복 제거 및 rdata_w 필터링으로 최적화
    - 문서화: 리팩토링 결과 및 면적 재측정 보고서 추가
    [my_mcu_top.cfg]
2026-05-20 A_MCU 레이아웃 관련 변경 사항 추가
    - comp.json 파일 생성: MCU의 핀 및 장치 정보를 포함.
    - comp.out 파일 생성: 서브회로 비교 결과 및 DRC 상태 요약.
    - my_mcu_top.gds 파일 생성: GDS 형식의 레이아웃 데이터.
    - run_drc_my_mcu_top.tcl 파일 생성: DRC 검사를 위한 TCL 스크립트 추가.
    - QFlow 밀도 스윕 및 라우팅 복구 문서 추가: 밀도 스윕 결과 및 최종 적용 상태에 대한 상세 기록.
    [my_mcu_top.cfg]
2026-05-20 my_mcu_top 모듈의 기능 최적화 및 면적 축소를 위한 코드 변경
    - RV32E_MODE 파라미터 추가 및 GPR 수를 32에서 16으로 축소
    - 데이터 버스 기능 비활성화 및 RF 인터록 제거
    - RF 읽기/쓰기 인터페이스 최적화
    - 외부 메모리 주소 비트 수를 32에서 11로 축소
    - 리셋 전략 변경 및 내부 클럭 디바이더 제거
    - 메모리 관련 기능을 조건부로 활성화/비활성화하는 구조로 변경
    - 문서화된 기능 포기 사항 및 최종 결과 정리
    [my_mcu_top.cfg]
2026-05-20 rs2 및 data memory 복구 검토 문서 추가
    - rs2 복구 및 data memory 복구를 위한 후보 검토 내용 정리
    - RTL 변경 사항 및 적용된 파라미터 설명
    - 합성 면적 비교 및 배치 결과 포함
    - 검증 결과 및 결론 정리
    [my_mcu_top.cfg]
2026-05-21 리팩토링: 면적 분석 결과를 문서화, 물리적 설계의 라우팅 및 합성 파일을 업데이트.
    [my_mcu_top.cfg]
2026-05-22 물리적 프로파일 테스트벤치 추가 및 MCU RTL과 합성 흐름 구성 업데이트
    [my_mcu_top.cfg]
2026-05-22 문서 추가
2026-05-28 테스트벤치 수정: rv32e 및 rv32i 컴플라이언스 테스트 추가 및 수정
    - rv32e 컴플라이언스 테스트를 위한 새로운 테스트벤치 파일(tb_rv32e_compliance.v) 추가
    - rv32i 컴플라이언스 테스트에서 UART 및 GPIO 관련 포트 제거
    - 물리적 프로파일 테스트에서 메모리 주소 및 예상 쓰기 값 수정
    - 메모리 쓰기 및 읽기 카운트 조건 수정
    [my_mcu_top.v, tb_physical_profile.v, tb_rv32e_compliance.v, tb_rv32e_directed.v, tb_rv32i_compliance.v]
2026-05-28 C_SERV_ALU_FPGA 프로젝트 추가
2026-05-28 계획 문서 추가
2026-05-28 ASIC 실행 유닛 및 FPGA 브리지 모듈 추가
    - serv_exec_unit.v: ASIC 실행 유닛 모듈 구현
    - serv_exec_fpga_bridge.v: FPGA와 ASIC 간의 인터페이스 브리지 모듈 구현
    - tb_serv_exec_unit.v: ASIC 실행 유닛에 대한 테스트벤치 추가
    - tb_fpga_bridge_exec_unit.v: FPGA 브리지 모듈에 대한 테스트벤치 추가
    - Vivado 시뮬레이션 스크립트 및 실행 파일 추가
    - 기본적인 연산 테스트 케이스 추가
    [serv_exec_unit.cfg]
2026-05-28 .gitignore 업데이트
2026-05-28 FPGA-hosted RV32I 시스템 구현 완료
    - `C_SERV_ALU_FPGA`의 FPGA 부분을 단순 프로토콜 브리지에서 실제 RISC-V 프로그램 실행이 가능한 호스트 시스템으로 확장
    - 새로운 RTL 파일 추가: `serv_fpga_host.v`, `serv_fpga_top.v`
    - 테스트벤치 추가: `tb_fpga_host_rv32i.v` 및 관련 시뮬레이션 스크립트
    - 현재 지원하는 RV32I 명령어 목록 및 실행 FSM 정의
    - Vivado 시뮬레이션 결과 및 테스트 프로그램 흐름 검증
    - 다음 단계로 외부 메모리 초기화 및 추가 테스트 계획
2026-05-28 RV32I directed regression 테스트벤치 및 시뮬레이션 스크립트 추가
2026-05-28 1-bit serial execution unit으로 전환 ASIC-facing 데이터 폭을 4-bit nibble에서 1-bit serial로 축소하고, 관련 RTL 및 testbench를 업데이트함. MPW 핀 예산에 맞추어 `busy`, `debug_state[2:0]`, `rsp_flags[5:0]`를 유지하며, 전체 latency는 증가하였으나 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
    [serv_exec_unit.cfg]
2026-05-31 C_SERV_ALU_FPGA 테스트벤치에 RISC-V 테스트를 위한 새로운 프로그램 파일 추가 및 시뮬레이션 스크립트 작성
    - xori 프로그램에 대한 hex, bin, elf 파일 생성
    - Vivado 시뮬레이션을 위한 run.bat 및 run.sh 스크립트 추가
    - RISC-V 테스트 케이스를 실행하는 run_compliance.sh 스크립트 추가
    - Vivado Tcl 스크립트(run_sim.tcl) 작성하여 시뮬레이션 환경 설정
    - xsim_run_all.tcl 파일 추가하여 모든 테스트를 실행하도록 설정
    - RISC-V 테스트를 위한 테스트벤치(tb_fpga_host_riscv_tests.v) 추가
2026-06-03 docs: serv_exec_unit top pin side 재배치 및 PnR 결과 문서 추가
    - MPW 28핀 pad frame에 대한 serv_exec_unit의 pin 배치 및 PnR 결과를 문서화함.
    - 전체 신호핀의 side constraint를 적용하여 PnR을 수행한 결과를 포함함.
    - 각 핀 그룹의 배치 및 수행 명령, 결과를 상세히 기술함.
    - Magic DEF reader의 경고 메시지에 대한 언급 및 후속 작업 계획을 포함함.
2026-06-06 백엔드 과정 진행
    [serv_exec_unit.cfg]
2026-06-06 문서 수정
2026-06-06 gds 추가
